lvdlvd/rotanimb01/doc/SETUP-ARDUPLANE.md

# Setup: stock ArduPlane on the bench

End to end, for someone with a NUCLEO-F767ZI, an STM32G474 board and the
parts in [README.md](../README.md). Every step names what "done" looks like. The traps
you will hit along the way are catalogued in [BENCH-OPERATIONS.md](BENCH-OPERATIONS.md) — read
its first section before powering anything.

## 1. Wire it

Common ground FIRST. The harness is a slave on the DUT's SPI3; four
chip selects demux the four emulated devices.

| signal | DUT NUCLEO-F767ZI | harness G474 |
| --- | --- | --- |
| SPI3 SCK | PB3 | PC10 |
| SPI3 MISO | PB4 | PC11 |
| SPI3 MOSI | PB5 | PC12 |
| CS accel | PD3 | PC3 |
| CS gyro | PD4 | PC2 |
| CS baro | PD5 | PC0 |
| CS mag | PD6 | PC1 |
| PWM 1-4 (TIM3) | PC6 / PC7 / PC8 / PC9 | PA0 / PA1 / PB10 / PB11 |
| PWM 5-8 (TIM4) | PD12 / PD13 / PD14 / PD15 | PC6 / PC7 / PC8 / PC9 |
| CAN | PD0 RX / PD1 TX | PB3 RX / PB4 TX — via two 5 V transceivers, STBY to GND |
| GND | common ground | |

DRDY outputs (harness PC4/PC5/PB6/PB7) stay unconnected: this
configuration polls. Only PWM 1-4 (aileron, elevator, throttle, rudder)
matter for flight; 5-8 are captured and reported. The CAN transceivers
need 5 V: at 3.3 V the bus never goes dominant and the DUT's CAN error
counter climbs forever (LEC = bit 0).

USB and consoles: the DUT's user USB (CN13) is SERIAL0/MAVLink; its
ST-Link VCP (USART3) is a debug console. The harness has two links and
you need both:

- its USB (PA11/PA12) is the **pseudocan** command/telemetry link
  (STATUS, DIAG, PARAM_VAL, TRUTH_*, and every command in);
- its **console** is USART1 PA9/PA10 at 115200. The once-a-second
  heartbeat (`fdm 1g`, altitude, psi, the post-lag surfaces, the PWM
  cal echo, the SPI counters) exists ONLY there, and `bench drive`
  reads it back after every command. On the breakout board, PA9/PA10
  go to the ST-Link's VCP pins and the console appears as the
  ST-Link's second CDC interface.

Untested alternative: a NUCLEO-G474RE has the same MCU and pinout, but
its on-board ST-Link VCP is on PA2/PA3 (USART2), PC13 is the user
button, and PA11/PA12 have no USB connector — so it would need a
USB-serial adapter on PA9/PA10 (`ROTANIMB01_CONSOLE`), a hand-made USB
cable, and the selftest's PA2/PA3 jumpers collide with that VCP. Nobody
has run it; the breakout is the known-good board.

## 2. Build and flash the harness

Toolchain: arm-none-eabi-gcc 15.2 (what this is built and tested with; the
sources are `-std=gnu23`, older compilers are untested),
GNU make, openocd. The harness build needs nothing outside this repository.

```
make -C src            # builds, runs the host-side gates (fdmgate, dccheck)
make -C src flash      # openocd over the ST-Link
```

`make flash` mass-erases the G474 and programs `rotanimb01.elf`. With
more than one ST-Link on the host:

```
make -C src flash OPENOCD_ADAPTER="-c 'adapter serial <serial>'"
```

To find which serial is which, read them off the USB descriptors — both
ST-Links enumerate under the same `/dev/serial/by-id/usb-STMicroelectronics_
STM32_STLink_<serial>-if02` pattern, so record the two serials once and label
them. **Do NOT use `st-info --probe` to tell them apart on a running bench:
it connects over SWD and RESETS THE HARNESS, losing every RAM-only setting
(FDM mode, PWM cal, engine model, noise scales) in one command.** If you have
probed, assume the RAM state is gone and redo section 6 before trusting any
reading.

Done looks like: the breakout LED (PC13, active low) blinks, and the
harness enumerates as a USB CDC device named `rotanimb01 hitl-harness`.
On Linux it appears as
`/dev/serial/by-id/usb-rotanimb01_hitl-harness_<uid>-if00`; on macOS as
a `/dev/cu.usbmodem*`. The console (115200) prints a heartbeat line
once a second: `fdm 0g` means the model is parked and the sensor
emulation serves rest truth. `rb01tool` (section 4) on the pseudocan
port shows STATUS and DIAG arriving at 10 Hz and 1 Hz.

Optional but recommended once: `selftest/` lets the harness master its
own sensor bus with seven jumpers (table at the top of selftest/main.c)
and replays a real driver's init sequences against the four register
models. `make -C selftest flash`, watch the console for PASS per device.

## 3. Build stock ArduPlane for the DUT

The board definition is two commits against upstream ArduPilot master,
shipped as patches in `dut/ardupilot/` (see the README there for what
they contain and why). Applied and built (plane + bootloader) on master as of
2026-07-27 (9bbfed9c91).

```
git clone https://github.com/ArduPilot/ardupilot.git && cd ardupilot
git submodule update --init --recursive
git am /path/to/rotanimb01/dut/ardupilot/*.patch
./waf configure --board NucleoF767ZI
./waf plane
```

Flash over SWD with openocd. The DUT needs connect-under-reset once
ArduPlane is running (a plain `halt` times out); this recipe works from
a cold board too:

```
openocd -f interface/stlink.cfg \
  -c "reset_config srst_only srst_nogate connect_assert_srst" \
  -f target/stm32f7x.cfg -c init -c "reset halt" \
  -c "program Tools/bootloaders/NucleoF767ZI_bl.bin verify 0x08000000" \
  -c "program build/NucleoF767ZI/bin/arduplane.bin verify 0x08018000" \
  -c "reset run" -c shutdown
```

The bootloader owns flash 0..96 K (its code in sector 0, the parameter
storage in sectors 1-2), the application starts at 0x08018000. Do NOT
`stm32f2x mass_erase` on later reflashes — it wipes the parameter
sectors; `program ... verify <addr>` erases only the sectors it writes.
Once the bootloader is on, `./waf plane --upload` over the DUT's USB
also works. The shipped `NucleoF767ZI_bl.bin` is prebuilt; to rebuild it,
`./waf configure --board NucleoF767ZI --bootloader && ./waf bootloader`
from a CLEAN `build/NucleoF767ZI` (the application build leaves
generated DroneCAN sources there that break the bootloader build).

Flash order matters when both boards are up: reset the harness first
(SPI bus quiet), then flash/reset the DUT. Flashing the DUT while the
harness SPI bus is live can wedge ArduPilot's accel driver in a reset
loop that a soft reboot does not clear.

Done looks like: the DUT enumerates as `ArduPilot NucleoF767ZI` on its
user USB and a MAVLink HEARTBEAT arrives (MAVProxy:
`mavproxy.py --master=/dev/serial/by-id/usb-ArduPilot_NucleoF767ZI_*-if00`).
"Config Error: Baro" at this point means an SPI wiring problem or a
harness that is not serving (check its heartbeat).

## 4. Host tools

```
cd rb01tool && go build          # interactive cockpit + PFD
cd tools/bench && go build       # campaign driver; GOOS=linux GOARCH=arm64 for a Pi
```

Go 1.21 or newer, standard library only (bench needs golang.org/x/sys
for termios, fetched by `go build`). `rb01tool -p <port>` names the
harness pseudocan port; without `-p` it looks for exactly one
`/dev/serial/by-id/usb-rotanimb01_hitl-harness_*` (Linux) or
`/dev/cu.usbmodem*` (macOS). tools/px4hil is Go 1.25 and depends on
github.com/lvdlvd/gomavlink (fetched by `go build`).

If the USB devices hang off a separate host (a Pi), run there:

```
bench serbridge -port 5760       # DUT MAVLink <-> TCP
```

and from the workstation add `-c <host-ip>:5760` to every `bench`
command. `bench drive ...` (harness commands) always runs on the host
the harness is plugged into. Device selection: `ROTANIMB01_HARNESS`,
`ROTANIMB01_CONSOLE`, `ROTANIMB01_DUT` name the devices; unset, a
`/dev/serial/by-id/` glob that matches exactly one device is used (two
ST-Links on one host make the console glob ambiguous — set the
variable).

## 5. First boot: parameters

The DUT parameters live in `doc/f5-bench.parm` (annotated — read the
comments, they are the accumulated reasons). Either

```
mavproxy> param load doc/f5-bench.parm
mavproxy> reboot
```

or, with the tool, `bench params -profile bench -reboot`, which stages
the tuning core plus the DroneCAN sensor config (GPS1_TYPE 9, ARSPD_TYPE
8 + SKIP_CAL, ARSPD_RATIO 1.6327), the synthetic INS calibration, and
verifies every write by readback. The tool's list (tools/bench/
missions.go) is the authoritative staged set — it adds NAVL1_DAMPING
0.75 and leaves the parm file's bench-comfort lines (logging off, RTL
autoland) alone; the parm file is the annotated record. Do one of the
two before expecting any fly check to pass.

Then sanity. **Do section 6 (harness init) FIRST if you have not already:**
the IMU, baro and airspeed checks below pass in either FDM mode, but the GPS
and EKF checks REQUIRE `bench drive mode 1` — the DroneCAN GPS feeder produces
no fix until the six-DOF model is running, and the EKF never leaves "waiting
for GPS config data". Measured on the bench: `fdm 0g` gives GPS_RAW_INT
fix=0 sats=0 at lat/lon 0; `fdm 1g` gives fix=3 sats=12 at the origin, with
nothing else changed.

- RAW_IMU: accel ≈ (0, 0, -1000) mg, gyro ≈ 0.
- SCALED_PRESSURE ≈ 1013.25 hPa / 15.0 °C.
- GPS_RAW_INT: fix 3D, 12 sats, position at the feeder origin
  (45.52688 N, 1.667291 E — open farmland in central France). No fix
  with CAN wired = transceiver STBY floating, 3.3 V supply, or swapped
  PD0/PD1.
- AIRSPEED ≈ 0 and healthy (ARSPD_SKIP_CAL 1 — the harness's zero IS
  the truth, and skipping boot cal protects a DUT rebooted mid-flight).
- After ~30 s: "EKF3 IMU0 is using GPS", origin and home set. This is
  the first acceptance gate.

Calibration: the harness is level and still, so use the synthetic INS
values in the parm file (a 6-pose accel cal is impossible — the model
will not hold poses) and a fixed-yaw compass cal (`magcal yaw 0`; the
harness serves the earth field at heading 0 after a reset).

## 6. Harness init — every session, every harness reboot

```
bench drive mode 1          # six-DOF model on, parked on the gear
bench drive setpos 0 0      # at the origin (a bare mode cycle does not reset position)
bench drive cal             # PWM calibration, ArduPilot sign profile — RAM-ONLY
bench drive engine 912      # naturally aspirated 100 hp (default); 915 = turbo, for high altitude
bench drive tail 3          # read the heartbeat back: fdm 1g
```

All of this is RAM state: lost on every harness reboot, reflash or
power cycle. Note what `tail` can and cannot confirm: it shows `fdm 1g`, psi,
altitude and the counters, but **there is no cal readback** — PWM_CAL is
write-only, and the `ctl` line is the post-lag surface deflection computed from
the DUT's live PWM, so at neutral PWM it reads `a 0 e 0 r 0` whether or not the
cal was ever sent. The first real evidence the cal took is the takeoff
rotating; `bench fly` reports "NO ROTATION (overspeed on ground)" if it did not. Without the cal the elevator is inverted for ArduPilot —
the aircraft never rotates, runs off the end of the runway at 50 m/s.
Then `bench reboot` the DUT and wait 45 s (clears a latched
"airspeed unhealthy").

## 7. Fly

The end-to-end check:

```
bench fly -alt 300
```

TAKEOFF-mode departure, climb, 60 s of hands-off FBWA at cruise
throttle, PASS/MARGINAL verdict with roll statistics. PASS = worst |roll| and
|pitch| both under 25° over the hands-off minute. Typical numbers on a healthy
bench land between about 7° and 17°, and which axis is the larger one varies
run to run — **a figure over 12° is NOT by itself evidence of dirty harness
state**, and chasing one with a reset is usually wasted time. A genuine FAIL
(over 25°), or a takeoff that never rotates, does point at harness state: redo
section 6 from a harness reset.

The documented demo flight is the 1 km square at 150 m,
`doc/example-square-1km.waypoints`, laid out from the feeder origin
(south-west corner) north and east. Item 0 of a QGC WPL file is the HOME slot
and ArduPilot overwrites it with the vehicle's own home, so the real mission
starts at item 1 — these files carry a placeholder home row for that reason.
A mission whose NAV_TAKEOFF sits at index 0 loses it silently on upload and
the aircraft then sits at idle throttle in AUTO, looking like a bench fault.
Note also that AUTO alone does not start the ground roll without a throttle
input; depart with `mode takeoff` (what `bench fly` does) and switch to AUTO
once airborne:

```
mavproxy> wp load doc/example-square-1km.waypoints
mavproxy> mode takeoff
mavproxy> arm throttle
        # ... climbing; once through TKOFF_ALT:
mavproxy> mode auto
```

`doc/example-straight-in.waypoints` is the same with a landing at the
origin. `bench loiter -takeoff` flies the two reference loiter legs
(standard 3°/s at 29 m/s, R 553 m; fast 6°/s at 38 m/s, R 363 m) with
demand-vs-achieved statistics and a CSV per leg; `bench probe`
cross-checks yaw vs GPS course vs EKF velocity vs airspeed.

## 8. Truth vs EKF

The harness reports the model's truth at 20 Hz over pseudocan
([TRUTH-TELEMETRY.md](TRUTH-TELEMETRY.md)). `rb01tool` shows it as a PFD next to the model
state; ArduPilot's ATTITUDE / GLOBAL_POSITION_INT from MAVProxy is the
estimate. The two are independent paths through independent hardware:
on a healthy bench they agree to a degree in attitude and metres in
position (the checkride numbers are in [F5-TESTREPORT-2026-07-15.md](F5-TESTREPORT-2026-07-15.md),
night 7). Do not use the DroneCAN GPS feed as truth — it is the
deliberately lagged, quantized feed the DUT consumes.

## 9. SITL first

Everything above also runs with no hardware at all, at 10x real time:

```
cd fdm && make sitljson && ./sitljson &
arduplane --model JSON:127.0.0.1 --speedup 10 --home 52.0,5.1,0,0 -w &
bench params -profile sitl -reboot
bench fly
```

Tune in SITL, then validate through the sensor path on the bench.
[tools/bench/README.md](../tools/bench/README.md) has the campaign tools and the session checklist.
