lvdlvd/rotanimb01/(commit log)

2026-07-08 M0-M3 baseline: skeleton, PWM capture, CAN link, SPI slave engine wired
    The harness app on the n-array platform (../n-array lib/periph/gen):
    - DESIGN.md v2 (hybrid SPI topology), pinout verified against the rebuilt
    AF data (FDCAN1 on PA11/PA12 is AF9), CAN dictionary updated to 29-bit
    bit-field headers + big-endian payloads.
    - src/: board def (narray-pinfmt'd), console + fault machinery, 8-channel
    PWM capture on TIM2+TIM3 (TIM2 doubles as the us clock), FDCAN1 at
    1 Mbit with the shared-dictionary headers (canmsg.h: harness owns the
    0x40 MSGID block), PWM reports 50 Hz + on-change, STATUS 10 Hz with
    stale-command watchdog, DIAG 1 Hz.
    - bmp390inv/: host golden model for the BMP390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
2026-07-08 DESIGN: record the M3-measured SPI slave deadline structure
    Dummy protocols native-speed reactive once the dummy is pre-stuffed at
    select; no-dummy protocols 1.3 MHz clean / 2.6 MHz marginal. Prediction
    reduced to a gyro-only question.
2026-07-08 doc: M4 register maps extracted for verification + DUT-driver findings
2026-07-08 M4a: the four sensor models on the single-SPI v3 topology
    DESIGN v3: all four devices demuxed on one SPI3 slave (M3 measurements
    made v2's hardware-NSS prediction path moot); PA4/PB12 become CS inputs
    on EXTI4/EXTI12, SPI1/SPI2 pins reserved as the hybrid fallback.
    src/sensors.{h,c}: BMI088 gyro+accel, BMP390, RM3100 register files per
    doc/REGMAPS.md — reset values (incl. RM3100 CC defaults, ArduPilot's
    whoami), write masks, deselect frame hooks for clear-on-read + DRDY pin
    release + deferred soft resets, self-test emulation (gyro 0x12 answer,
    accel +-deflection >= 2048 LSB, RM3100 BIST XOK/YOK/ZOK), rates and
    scale factors derived from the live config registers, BMP390 served from
    the tr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
    [board.c, board.h, main.c, sensors.c, sensors.h]
2026-07-08 selftest: M4a probe test; IRQ priorities in preemption levels
    selftest/: the board masters its own sensor bus — v3 freed SPI1, so seven
    jumpers (PA5>PC10 PA7>PC12 PA6>PC11, PB0>PC0 PB1>PC1 PA2>PA4 PA3>PB12) put
    lib/spi.h at 1.3 MHz against the four models and replay the flight-tested
    init sequences: chip ids, self-test dialogues, soft resets, config with
    readback, DRDY pin assertions read back on-chip, and a data check per
    device — the baro raw words are forward-compensated on the master side and
    must reproduce the ISA sea level the slave's trim inversion encoded.
    Shares ../src generated files and sensors/board sources.
    IRQ priorities (harness + selftest), 2:2 grouping in the house styl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
    [main.c, sensors.c, sensors.h]
2026-07-08 M4b: the BMI088 FIFOs as the ArduPilot driver drives them
    sensors.c renders both FIFOs through the engine's streaming register,
    spec extracted from the AP driver (doc/REGMAPS.md addendum): accel
    headered 7-byte 0x84 frames, FIFO_LENGTH le at 0x24, 146-frame capacity,
    silent stop-at-full, cleared by any FIFO config write; gyro headerless
    6-byte frames, FIFO_STATUS count|overrun at 0x0E, 100 frames, overrun
    raised at full and cleared - with the FIFO - by rewriting FIFO_CONFIG1
    (AP's recovery). Wmasks grew the registers AP writes and readback-checks:
    accel 0x45-0x49, gyro RATE_HBW 0x13 + 0x3D/0x3E. Commits append frame +
    length registers in one atomic spidev_apply so a select never observes a
    t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
2026-07-09 M5: physics + 10 kHz table scheduler + CAN command decode
    physics/: commanded NED state (V, hdot, psidot) through 0.4 s first-order
    lags -> coordinated flight (gamma = asin(hdot/V), tan phi =
    psidot*V*cos(gamma)/g, theta = gamma + 2 deg trim AoA) -> strapdown body
    rates, specific force by differentiating the NED velocity vector, tilted
    earth field, ISA baro from QNH + integrated h. All truth in body FRD
    (level = -1 g on z; DUT mounts ROTATION_NONE). Trig is libm, not CORDIC
    (user-approved): the step is small enough, and the model stays dependency-
    free and host-compilable — golden.c asserts the DESIGN maneuver scripts
    and passes (level |f| = g with trim-AoA x; standard turn phi 15.9 deg,
    l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
2026-07-09 v3 CS demux on PC0-PC3; report crashes before bus bring-up. M4 gate PASSED
    The v3 first draft scattered the four CS inputs over three ports (PC0,
    PC1, PA4, PB12) — but spislave's CS handler arbitrates from ONE IDR read
    and spislave_init asserts one port. The assert fired inside sensors_init
    on every boot, BEFORE fault_report ran: a silent reset loop (bench:
    no output at all). Three fixes:
    - CS gyro -> PC2, CS accel -> PC3: all four CS on port C, each on its own
    dedicated single-line EXTI vector (0-3); the shared EXTI15_10 handler is
    gone. board.c completes the v2->v3 migration (SPI1/SPI2 slave pin blocks
    removed to the analog blanket, reserved as the hybrid fallback).
    - fault_report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
    [board.c, board.h, main.c]
2026-07-09 regenerate device.h/devs.ld (USB + CRS); enable tprintf %f
    The generated headers now carry the USB_FS device (EPR[8] form + USB_RAM
    PMA symbol) and CRS, for the upcoming pseudocan-over-USB console (note:
    USB shares PA11/PA12 with FDCAN1 — the two transports are mutually
    exclusive at runtime). Makefiles opt into tprintf float formatting
    (-DPRINTF_ENABLE_FLOAT); libm doubles are already on board.
2026-07-09 host link transport: pseudocan over USB (default) or FDCAN1 (lab)
    TRANSPORT=usb (default): the canmsg dictionary tunnels as pseudocan
    lines (lib/fmtcan, no per-line crc — USB bulk has link-level integrity)
    over the CDC-ACM VCP; the board enumerates as /dev/cu.usbmodem<die-id>.
    Same mailboxes, STATUS/PWM/DIAG streams (port field 1), host lines
    parse straight from the usb fifo into host_msg(), output is DTR-gated
    so nothing accumulates against a closed port. TRANSPORT=can keeps the
    FDCAN1 build for the lab bench. The two share PA11/PA12 — a wiring-
    level either/or, hence a build-time choice (an #ifdef pair to clean
    out once the transport question settles, per the todo).
    board.c: USB kerne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
2026-07-11 F0: fdm host-first — Kitfox V 6-DOF core + golden validation ladder
    fdm/fdm.{h,c} per fdm-DESIGN.md mode 1: 13-state rigid body (body vel,
    rates, quaternion, int32-cm NED position), component-buildup aero with
    C1 smoothstep stall blend to flat plate + pitch-down bias, Beard-McLain
    prop (anchors: 1600 N static, 890 N at 46 m/s 75%) with torque reaction,
    steady wind + Gauss-Markov gusts (off by default), semi-implicit Euler.
    Freestanding float32: cordic float API only, no libm, no doubles; ISA as
    a 16-knot cubic Hermite table built once with cordic exp/log (hydrostatic
    derivatives at the knots); -Wdouble-promotion -Werror. Sequential level
    trim (CL->alpha->de, drag->throttle) with IAS in, TA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
    [fdm.c, fdm.h, golden.c]
2026-07-11 harness baro: emulate the bench BMP388 — real NVM trim + CHIP_ID 0x50
    The BCLBR dump from the real part (via srcg4 on the bench) replaces the
    synthetic trim, so the emulated register file serves the actual part's
    NVM byte-for-byte; CHIP_ID goes 0x60 -> 0x50 (BMP388, as on the bench;
    both ids accepted by every driver in play). Verified: trim_regs
    reproduces the dump exactly, and the inversion round-trips < 3 Pa /
    0.02 C over -20..50 C x 540..1060 hPa with the real coefficients.
    Selftest expectation updated.
    [main.c, sensors.c]
2026-07-12 sensors: DRDY pins pulse per sample; mag rate from cycle counts; frame trace
    DRDY semantics: only the gyro auto-released its DRDY (300 us); accel,
    baro and mag held a level until a data read cleared it. The DUT arms
    its EXTIs after probing, so a level asserted during the probe never
    yields an edge and never gets read — deadlock. Real parts re-pulse
    per sample (non-latched interrupts): all four DRDYs now assert at
    commit and auto-release 300 us later in sensors_poll (commits take
    now_us).
    Mag rate: TMRC is only the ceiling — the cycle counts set the
    measurement duration, ~30000/CC Hz over three axes (CC=150 -> 200 Hz,
    matching the bench part).
    Bring-up tooling: every frame hook pushes {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
2026-07-12 heartbeat: scrubfail + qcmd engine probes (chained-frame displacement hunt)
2026-07-13 heartbeat: drop the scrubfail/qcmd probes — the select race is gone
    Bench state with n-array's permanently-selected spislave: all four
    sensor pipelines flight-exact through the emulator (gyro quaternion
    integrating, accel autoscale converged to -1 g, mag at earth field,
    baro round-tripping the real trim), tsync at ~1 us DTS, 357k frames
    with zero unexpected/stray at 78% bus utilization.
2026-07-13 rb01tool: console cockpit for the harness over pseudocan/USB
    Connects to the CDC-ACM port, repaints the live state ~10x/s (STATUS
    with psi and the cmd-stale badge, PWM 1-8, DIAG, a rate table of all
    traffic) and steers the physics from single keys: V/v speed, H/h
    climb, R/r turn rate, SPACE level, P/p QNH, T/t temperature, e ISA
    reset. CMD_STATE auto-repeats at ~3 Hz with a rolling seq so the
    harness's 1 s stale timer stays fed; CMD_ENV goes every 2 s.
    Wire codec per lib/fmtcan and src/canmsg.h: lenient parser (crc,
    port, fmi each optional; a present crc must verify), sends carry the
    crc; priority-preserving header representation as in lib/can.h.
    Tests anchor the codec to a line captured of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
2026-07-13 F1: the six-dof flies on the harness at 1 kHz behind the mode switch
    fdm.c joins the target build with its gate: fdm.o must compile
    -Wdouble-promotion -Werror clean and reference no soft-double helpers
    (FPU float32 + CORDIC only; CORDIC clock enabled in board init). The
    cordic frontend now provides sinf & co for the whole image — they beat
    libm at link time; only mode-0's asinf still comes from newlib.
    The 10 kHz scheduler gains a 1 kHz six-dof slot behind fdm_mode; all
    six truth consumers (samplers, baro, STATUS psi, heartbeat) route
    through one truth() switch, mode 0 untouched and default. FDM_MODE
    (TMC 0x43) selects, FDM_INIT (TMC 0x44) air-starts via the trim solver
    at thread level. C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
2026-07-13 rb01tool: FDM mode toggle and air-start keys; full-frame command payloads
    'i' air-starts (FDM_INIT then FDM_MODE 1), 'm' toggles the truth
    source; all command payloads padded to the 8-byte frames the harness's
    truncation guard requires.
2026-07-13 F2: the PWM path — the DUT's servos fly the six-dof
    controls.{h,c}: per-channel AETR calibration (min/trim/max us, signed
    full deflection; defaults 1000/1500/2000, ±20° aileron, ±25°
    elevator/rudder, throttle 0..1), piecewise-linear around trim so the
    DUT's servo trims need not sit at 1500; zero-order hold on the 50 Hz
    captures; first-order servo lag (60 ms surfaces, 0.3 s throttle) with
    a 300 deg/s rate limit, stepped at the FDM's 1 kHz; PWM_CAL (TMC 0x45)
    sets the table live. Failsafe ageing per the design — 100 ms to hold,
    600 ms to calibration trim with throttle to idle, STATUS bit 4 — with
    one refinement: a channel never captured since boot keeps flying the
    FDM_INIT trim solut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
    [canmsg.h, controls.c, controls.h, main.c]
2026-07-13 TRUTH telemetry: the six-dof narrates itself at 20 Hz (F3 first half)
    MEAS 0x44-0x47 in fdm mode: TRUTH_POSVEL (altitude, climb,
    groundspeed), TRUTH_ATT (the quaternion, i16 x 2^15), TRUTH_AIR
    (IAS at sea-level density from qbar, TAS, alpha, beta), TRUTH_CTRL
    (the post-lag deflections and throttle). F3's remaining half — WIND,
    PARAM_SET and its readback — stays open.
2026-07-13 rb01tool: an ascii-art PFD on 'f', fed by the TRUTH telemetry
    Airspeed tape left, altitude tape right, current values boxed and
    bold; compass tape with the boxed heading below; the horizon line
    through the center pitched and rolled per the quaternion (right roll
    renders the horizon rotated counter-clockwise, as a PFD should), a
    fixed __ W __ aircraft symbol, and a data strip with IAS/TAS/ALT/VSI/
    GS plus the live control deflections. Render covered by tests that
    print the art at known attitudes — bench-verified delightful.
2026-07-13 fdm: turncheck — the direction audit the eigenvalue golden can't do
    Right aileron must roll right; a sustained right bank must yaw right
    and turn the velocity vector right — pulsed and held, checked on the
    host with the same cordic math as the target. Result: the model is
    correctly signed and fully coordinated in sustained turns (held +2 deg
    aileron: bank 12->59 deg right, psi through a full right circle,
    course tracking, beta ~+2.5 deg). The pulse case documents the honest
    surprise: the spiral mode is strongly convergent with dutch-roll
    overshoot (a 6.5 deg bank self-levels in ~15 s, briefly carrying a
    LEFT roll rate while still banked right) — moments that read as
    'turning left while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
    [turncheck.c]
2026-07-13 F3b: WIND and PARAM_SET — the tuning surface, plus feeder truth
    WIND (TMC 0x46): steady NED cm/s + Gauss-Markov gust sigma/tau.
    PARAM_SET (TMC 0x47): any fdm table entry by float index, with the ISA
    rebuild side effect handled in fdm_param_set; index|0x8000 reads back
    as PARAM_VAL (MEAS 0x48). TRUTH_POS (0x49) and TRUTH_VEL (0x4A) join
    the 20 Hz truth set — the GPS feeder needs N/E position and the NED
    velocity vector, not just the PFD's altitude and groundspeed.
2026-07-13 rb01tool: F4 — the DroneCAN GPS/airspeed feeder, and wind/gust keys
    -gps <port> republishes the (configurably lagged, default 150 ms)
    flight truth as uavcan.equipment.gnss.Fix2 + air_data.RawAirData at
    5 Hz onto a second pseudocan port — the canusb bridge to the DUT's CAN
    bus. Zero-lag GPS would make HITL kinder than reality, so the lag is a
    first-class flag. The differential pressure comes exactly from IAS
    (the harness defines IAS from qbar, so 0.5*rho0*IAS^2 round-trips).
    dronecan.go is a minimal UAVCAN v0 broadcast encoder: faithful ports
    of libcanard's bit codec, float16 and transfer CRC/framing, message
    layouts per ArduPilot's dsdlc — and every byte pinned by tests against
    refere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
2026-07-13 F4 on board: the harness feeds DroneCAN GPS + airspeed itself
    FDCAN3 on PB3/PB4 straight onto the DUT's CAN bus — no bridge board,
    no second USB hop, and the GPS lag is exact against the harness's own
    microsecond clock. Fix2 + RawAirData at 5 Hz from a lagged ring of fdm
    truth snapshots (default 150 ms, GPS_CFG TMC 0x48 sets enable and lag
    in 10 ms units), NodeStatus at 1 Hz so ArduPilot sees node 42 alive.
    Position in integer 1e-8-degree math from a 52N/5.1E origin — float32
    cannot carry those magnitudes. Differential pressure is exactly
    0.5*rho0*IAS^2, the inverse of how the harness defines IAS.
    dronecan.{h,c}: a freestanding UAVCAN v0 broadcast encoder — faithful
    ports of libcanard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
    [board.c, canmsg.h, dccheck.c, dronecan.c, dronecan.h, main.c]
2026-07-15 F5 checkride: the harness learns to fly ArduPlane for real
    The bench nights' harvest, in one coherent state:
    DroneCAN feeder made transport-independent and honest: FDCAN clock,
    pins, irq handlers and vector slots out of the TRANSPORT_CAN ifdefs
    (three separate latent deaths in USB builds, one per layer); the
    missing IR.RF1N w1c in fdcan3_it1 — first RX frame ever = permanent
    interrupt storm at 100% CPU (console, USB and SWD all dark; masked for
    days by the DUT's dead transceiver); Fix2's 13-frame bursts queued
    through lib/canmsgq and pumped from the tx-complete irq (3 hw buffers
    truncated every transfer); all CAN drains bounded per the aerospace
    rule; gps tx/busoff/LEC counters on the hea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
    [f5-bench.parm]
2026-07-15 doc: F5 flight test report — checkride flown
    Chain proven end to end; takeoff and FBWA pass outright, LOITER-in-wind
    and TECS climb functional pending airframe tuning. Thirteen defects
    found and fixed across two bench nights — the HITL rig doing its job.
2026-07-15 M7'-lite noise layer, toe brakes, and the night-3 verdict: tuning holds
    Datasheet-scale white noise on gyro/accel/mag (physical units, before
    quantization, so it tracks the DUT's configured ranges) joining the
    baro dither. The acceptance mission completes with noise at the same
    envelope as without — the DUT is not living off unnatural cleanliness.
    Ground model: toe brakes below 15% power — the power-based prop pushes
    ~160 N at ArduPilot's disarmed idle and the aircraft taxied itself in
    circles (which also wedged the DUT's estimator into a never-recovering
    inverted attitude; the bench driver now auto-reboots the DUT when the
    parked estimate is stuck, exercised four times unattended).
    f5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
    [f5-bench.parm]
2026-07-15 gyro bias: turn-on offset + 3D random walk — the noise that matters
    A wandering gyro bias is why attitude filters carry bias states and
    lean on accel+mag as the low-bandwidth reference; without it the EKF's
    hardest job was missing from the bench. BMI088-class numbers: per-boot
    turn-on sigma 0.15 deg/s (the DUT's boot cal now removes something
    real), in-run walk 0.002 deg/s per sqrt(s) (the EKF must keep
    tracking). Small fixed accel turn-on bias too. The acceptance mission
    completes with the full model — validated in flight.
    Bench driver: auto-reboot the DUT when its parked attitude estimate is
    stuck (post-crash railed-bias lockup), takeoff retries wired through.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
    [main.c]
2026-07-16 autotune cracked: event-based learning, in-mode readback, learned gains
    AP_AutoTune learns only from events (rate demand over ~30 deg/s with
    attitude error over 12 deg), fits FF per event with a 4-event median,
    then raises D and P to provoked oscillation — and restores everything
    on mode exit unless both limits were found. Stick holds produce no
    events; bank-crossing reversals do. tools/bench/autotune2.py flies the
    correct pattern and reads gains while still in the mode. Learned: this
    airframe wants ~9x default roll FF. Candidates in f5-bench.parm; the
    mission completes with them, and the residual loiter excursions now
    read as demand-side, not tracking.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
    [f5-bench.parm]
2026-07-16 night 4 consolidation: roll tune validated, pitch tune rejected by A/B
    Autotuned roll gains are A/B-proven good; both autotuned pitch ladders
    ended in crashes and their gains destabilize the loiter — pitch stays
    at defaults, documented with the convergent FF for a future completed
    tune. Loiter radius per the owner's airmanship: rate-turn geometry
    (300 m), not tight circles. Demand-vs-achieved instrumentation lands
    in the mission driver and immediately reframes the problem: L1 demands
    37 deg median bank where the orbit needs 19, and roll tracking error
    is ~20 deg median across all gain sets — next session wants dataflash
    logs, not more blind runs. Takeoff: proportional EMA speed-hold clim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
    [f5-bench.parm]
2026-07-16 night 5: instrumented loiter campaign — findings chain
    Standard/fast loiter per the owner (3 and 6 deg/s), flown with 25 Hz
    recording and offline analysis. The chain: the model's true cruise is
    38 m/s (the owner's 90 kt — the prop model is his engine); the first
    legs commanded a speed below the accelerated stall at the demanded
    bank, making rosettes of the orbits; WP_LOITER_RAD latches at mode
    entry and DO_CHANGE_SPEED is inert in LOITER; with all that fixed the
    remaining, precisely-characterized problem is L1 loiter capture
    (saturated bank demand orbiting a displaced center). Bonus fidelity
    milestone: the gyro bias walk drifts DCM into the DCM-vs-EKF arming
    check — the bench now repro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
    [f5-bench.parm]
2026-07-16 night 7: SITL rig cracks the tuning; bench flies identical to the model
    fdm/sitljson.c: ArduPilot SITL JSON-backend wrapper around the same
    fdm.c the harness flies (SIL under the HIL) — lockstep UDP :9002,
    harness actuator model included, --speedup 10 tuning campaigns.
    Tuning results (SITL, validated on the bench):
    - pitch AUTOTUNE completed: FF 1.6387 P 8.3447 I 6.2585 D 0.4981,
    TCONST 0.75 (the bench ladders never got through; FF matches their
    ~1.65 convergence)
    - both loiter legs textbook on BOTH rigs: std 29.0 m/s R568/569,
    fast 38.0 m/s R374 — identical to the meter
    Three latent bench defects closed on the way:
    - harness PWM cal is RAM-only; reboot reverts elevator to the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
    [f5-bench.parm]
2026-07-16 docs into doc/, stack README, tools/bench rewritten in Go
    DESIGN.md and fdm-DESIGN.md move to doc/ (source references updated);
    a top-level README now documents the whole HITL + SITL stack: the
    loop, directory map, both rigs, and the short list of operational
    truths (the long list stays in the test report and parm comments).
    tools/bench: the python campaign scripts are replaced by one Go
    binary (stdlib + x/sys, no cgo) with subcommands params / fly /
    loiter / probe / tune / disarm / reboot / drive / serbridge — the
    python that flew the F5 checkride remains checkpointed at 537e750
    for A/B re-verification. The MAVLink2 codec carries only the
    dictionary this bench speaks and is byte-pinned b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
    [board.c, board.h, fdm.c, main.c]
2026-08-06 bench: ride out wifi outages in the param path
    Two campaigns died on 2026-08-06 with all retries spent inside a single
    multi-second wifi outage (bench RTT swings 6 -> 437 ms, occasional
    outright drops): params staging aborted on AIRSPEED_CRUISE, and a
    loiter campaign died at its first leg's speed change. Get/SetParam now
    try 6 x 3 s (18 s horizon), and cmdParams collects failures for a second
    full pass instead of aborting on the first. leg() stays strict: a leg
    flown at an unverified speed is mislabeled data.
2026-08-06 bench: mode subcommand
    bench mode rtl is the missing "bring it home" — with RTL_AUTOLAND 2
    staged the plane flies home and lands itself, which beats leaving a
    probe-abandoned FBWA plane to wander into the ground.
2026-08-06 harness: GPS feeder origin to the vnav map region
    52.0N/5.1E was a placeholder; the camera's map tiles, model and golden
    frames live at 45.52688N/1.667291E (Limousin, golden frame f15), so the
    bench now flies where the camera can navigate. East cm->deg factor
    recomputed for cos(45.52688) = 0.70057. Origin remains hardcoded — if
    regime moves become routine, promote it to a command like FDM_INIT.
    Bench-verified: DUT GPS_RAW reads 45.52688/1.66729 at the parked
    origin; airstart 4595 m trims and flies (ISA density honest to 5100 m).
2026-08-06 bench: arm subcommand (airstart flights arm on the ground first)
2026-08-07 harness: stale-timer wrap — fdm enabled after ~36 min emitted nothing
    The 20 Hz TRUTH_*, 5 Hz DroneCAN feed and 1 Hz NodeStatus timers
    compared (int32_t)(now - t_x) against their periods with t_x still 0
    from boot. Past 2^31 us (~35.8 min) of uptime that difference wraps
    negative, so a session that enabled fdm_mode late got a harness that
    stepped the FDM and printed "fdm 1" on the console while emitting no
    truth and no GPS — exactly the 2026-08-07 morning bring-up, and
    retroactively yesterday's "gps tx at 1 Hz" puzzle. Unsigned deltas:
    first fire immediate, wrap-safe forever.
2026-08-07 fdm: the engine is a configuration — honest 912iS default, 915iS preset
    The power-based prop used a hardcoded 74600 W with no density
    dependence: a perfect-turbo fantasy at any altitude (and the CpSp
    param the "turbo" tweak scaled was torque-only — a no-op; yesterday's
    altitude rescue was the wider loiter radius all along). Engine is now
    three runtime params: power_w, t_static_n, crit_alt_m. Naturally
    aspirated engines (crit_alt 0) lapse with density from sea level; a
    turbo holds rated power to crit_alt and lapses above. Defaults are the
    owner's actual 912iS (74600 W, 1601 N, NA); `bench drive engine 915`
    presets the turbocharged 915iS (141 hp to FL150) so high-altitude HITL
    flies a lega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
2026-08-07 src: adapt to the n-array family split (dma_g4.h + usart_v3.h)
    n-array 34bfac9 split dma.h/serial.h into family headers (G4 behavior
    unchanged); the app now pulls dma_g4.h and usart_v3.h explicitly.
2026-08-10 sitljson: optional UDP truth tap for the SITL visual-nav driver
    sitljson [truth_port] mirrors the JSON reply (decimated to ~10 Hz) to
    localhost:<port> — the nav driver reads the same truth the autopilot's
    sensors derive from, the software twin of the bench's TRUTH_* stream.
2026-08-15 bench: watch + hdgaltcmd subcommands, alt/aspd error in state; sitljson airstart port; fix harness console default
    - bench watch: passive state stream (mode/alt/climb/ias/thr/pitch/nav/
    roll + NAV_CONTROLLER alt & aspd errors) for diagnosing mode behavior
    without touching the aircraft.
    - bench hdgaltcmd: send HDGALT_COMMAND (dev msg 52100) so recipes can
    set the altitude target explicitly instead of relying on capture-at-
    entry — required after an airstart teleport (stale-target dive).
    - sitljson: UDP :9003 'airstart <alt> <ias> [hdg]' with the harness's
    fdm_trim semantics, so the SITL rig can replicate bench airstarts.
    - drive.go: default harness console ST-Link path was a stale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
    [sitljson.c]
2026-08-15 sitljson: send EAS, not TAS, in the JSON airspeed field
    SIM_JSON feeds the received airspeed straight into its pitot model,
    whose convention is EAS. Sending the fdm's va (TAS) read ~26% high at
    4600 m, tripping ArduPilot's airspeed consistency check (sensor
    disable/re-enable flapping) and HDGALT's airspeed-floor disengage at
    the airstart teleport. Convert via qbar exactly as the harness does
    for TRUTH_AIR ias.
2026-08-28 harness: FDM_POS (0x49) bench rehome; bench drive setpos + airstart heading fix
    drive airstart silently dropped its heading argument (payload bytes
    4-5 were never filled) — now sent, plus optional [north_m east_m]
    rehome-then-trim. New CANMSG_FDM_POS teleports the FDM ground position
    (N/E cm; alt/attitude/energy untouched) so a wandered bench aircraft
    returns to the vnav origin in one command instead of a 90-minute
    transit. Flashed + verified on the bench 2026-08-28.
    [canmsg.h, main.c]
2026-08-28 serbridge: tolerate VMIN=0 empty reads; reopen only on persistent EOF
    openSerial configures the tty VMIN=0/VTIME=0, on which a drained
    cdc-acm buffer read()s 0 bytes — io.EOF to Go — and serbridge treated
    any EOF as a lost device and reopened. A freshly opened fd starts
    empty, so the reopen read EOF again: a self-sustaining EOF/reopen
    storm (the all-day 2026-08-28 '54 s CDC wedge' metronome, 227 kernel
    resets — the device was healthy throughout; pyserial read 37 KB of
    clean truth from the 'wedged' port mid-storm). Now an EOF is treated
    as no-data-right-now and the reopen fires only after 2 s of
    continuous EOF with no bytes, which still recovers real unplugs
    (bench power cycles), the re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
2026-08-28 bench fly: record a roll-vs-demand series during the hands-off leg
    The wobble debug wanted the oscillation period (rate-loop seconds vs
    L1's ~17 s) and whether demand leads or follows; cmdFly now samples
    attitude/nav/servo at 10 Hz into fly-handsoff-<ts>.csv. First use
    resolved the 2026-08-28 blocker: the 39-40 deg readings were dirty rig
    state — a clean ladder flies the leg at |roll| <= 0.3 deg with the
    worst-case being the FBWA-entry transient decaying in ~3 s.
2026-08-29 px4hil: PX4 SITL bridge around the harness fdm, flight-verified v0.2
    Go+cgo wrapper serving HIL_SENSOR (250 Hz, dithered) + HIL_GPS (5 Hz)
    to PX4's simulator-mavlink TCP-client mode on :4560, with the harness
    actuator-lag model and a sitljson-format -truth JSON UDP tap for the
    vnav driver.
    Bring-up fixes over the v0.1 draft: negate elevator/rudder (PX4 outputs
    are +ve-body-torque, the fdm uses classic aero signs, same negation
    sitljson does for ArduPilot), fix the 100x GPS lat/lon scale (PosCm is
    cm), and dither each sensor at its noise floor because PX4's
    DataValidator declares a source STALE after 100 bit-identical samples.
    Verified against px4_sitl_default + the 5100_px4hil_kitfox airfr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
2026-09-01 harness: close four emulator gaps a second SPI consumer exposed
    Flying PX4 against the same harness that flies ArduPilot exercised
    register behavior real silicon has but ArduPilot's drivers never
    touch, so the emulation never modeled it:
    - the BMI088 accel FIFO is entered EARLY: PX4's driver reads
    FIFO_LENGTH_0/1 (0x24/0x25) and the 0x26 burst port in one
    transaction, relying on the part's address increment. Served by
    mirroring the two length bytes into the stream head and entering
    the port two registers early (n-array stream_prefix, 32a90d2).
    - gyro FIFO_WM_ENABLE (0x1E) made writable; PX4 writes it, and a
    refused write fails its probe.
    - baro TRIM_CRC (0x30) now serves the Bosch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
    [sensors.c]
2026-09-01 bench drive cal: per-autopilot profiles (ardupilot|px4)
    The two stacks want different PWM sign conventions from the same
    harness: ArduPilot flips only the elevator; PX4 outputs positive
    body torque in FRD, so elevator AND rudder flip (ail +20, ele -25,
    rud -25). Bare 'drive cal' keeps the ardupilot profile, so existing
    runbooks are unchanged — but always name the profile: the wrong one
    flies with a reversed rudder. The cal remains harness-RAM-only;
    resend after every harness reboot or reflash.
    Verified surface-by-surface disarmed via actuator_test against the
    harness decode, then by the flown missions.
2026-09-01 doc: PX4 bench mission files (1 km square, straight-in landing)
    QGC WPL 110 files as flown on the bench: the 6-item square that
    produced mission-truth-20260831.csv, and the 4-item straight-in
    (NAV_TAKEOFF 150 m, 120/80 m approach, NAV_LAND at the feeder
    origin) that verified the FW_LND_USETER=0 landing fix 2026-09-01.
    PX4 mission-protocol notes (no home item at seq 0, no re-sent
    MISSION_COUNT mid-transfer) live with cmd/px4scaffold in vnavigator.
2026-09-02 vendor the n-array lib into src/nlib: self-contained, missing-only refresh
    This repo now builds with no n-array checkout anywhere on the path. The lib
    sources it actually uses are copied into src/nlib/ and the narray-generated
    files sit in src/, all tracked; selftest/ and fdm/ share that one copy and
    delegate to src/ for it, as they already did for the generated headers.
    The rules that fetch and generate carry NO prerequisite on the checkout, so
    a file already present is never refreshed behind your back: n-array can
    evolve freely without breaking anything here, and these copies are ours to
    edit. The single gesture that reaches upstream is
    make -C src n-array-clean && make -C src
    which ta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
    [binary.h, can.h, canmsgq.h, clock.c, clock.h, console.c, console.h, cordic.h]
2026-09-02 fdm, bmp390inv: vendor the two sibling-repo files, same model as nlib
    The last two things this repo reached outside itself for were host-test
    inputs: fdm's golden linked cordic-math's math_emul.c, the bit-exact host
    emulation of the CORDIC, and bmp390inv's golden compiled bminator10's
    bmp388.c as the integer reference its inverse is checked against. Both are
    now copies here, under the same rule as nlib/ — no prerequisite on the
    sibling checkout, so a present copy is never refreshed, and
    make cordic-math-clean && make (in fdm)
    make bminator10-clean && make test (in bmp390inv)
    is how you deliberately take the current one and see whether we still agree
    with it. The clean targets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
2026-09-08 bench drive gps: enable/disable the harness DroneCAN GPS feeder
    `bench drive gps <0|1> [lag_ms]` sends GPS_CFG (canmsg.h 0x48: u8 enable,
    u8 lag in 10 ms units, zero-padded frame) — the runtime switch the
    harness already honoured but no tool exposed. Needed for the prod-0.1
    acceptance's GPS-denied segment (release-manager prereg 2026-09-08)
    without touching the autopilot's parameter sector. Pinned wire vectors
    in drive_test.go, header derived independently from the id29 layout
    comment.
    User word 2026-09-08 via the leader ("yes to c").
2026-09-08 harness: DroneCAN air data at 20 Hz, unconditional from boot
    The DUT never bound an airspeed sensor. Measured on the bench: valid
    RawAirData on the wire from node 42 (differential 703.9 Pa => 33.9 m/s,
    correct DSDL layout and signature) while ArduPlane kept ARSPD_DEVID at 0
    across clean boots. Cause is on the consumer side and is one-shot:
    AP_Airspeed::init() runs exactly once (AP_Vehicle.cpp:450) and
    AP_Airspeed_DroneCAN::probe() binds only a node whose RawAirData has
    ALREADY been handled, so a feeder that starts talking later never binds
    for that boot. Ours started talking only in fdm mode 1.
    So RawAirData leaves gps_feed() for its own gps_feed_air(), sent from the
    first scheduler tick wi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
    [main.c]
2026-09-11 build: self-contained tree, MIT licence
    Everything the firmware and the host tools compile now lives in this
    repository: the bare-metal support library in src/nlib, the generated
    device files beside src/Makefile, the CORDIC host emulation in fdm/ and
    the BMP388 compensation reference in bmp390inv/ are plain tracked
    sources, and the Makefiles no longer carry refresh rules for them.
    tools/px4hil builds against the published gomavlink module and includes
    the fdm and lib sources from this tree. Section and startup helpers get
    descriptive names (FASTCODE, DMABUF, startup_init_memory,
    startup_remap0); the crash dump's backtrace marker is CRASH-BT. Firmware
    images are byte-identical before and afte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
    [clock.h, cordic_stm32.c, dma.h, exti.h, fault.c, fault.h, fdcan.h]
2026-09-11 tools: device selection by environment or by-id glob
    bench drive/serbridge no longer carry one bench's USB serial numbers:
    ROTANIMB01_HARNESS, ROTANIMB01_CONSOLE and ROTANIMB01_DUT name the
    devices, and without them a /dev/serial/by-id glob that matches exactly
    one device is used. The drive usage strings list setpos, gps and engine.
    Comments on the feeder origin, the engine defaults and the px4hil truth
    tap describe the tool rather than one installation.
    [fdm.c, main.c]
2026-09-12 doc: setup guides for stock ArduPlane and PX4, bench operations, FDM tuning
    New user documentation: doc/SETUP-ARDUPLANE.md and doc/SETUP-PX4.md
    take a stranger from wiring to the 1 km square mission; doc/BENCH-
    OPERATIONS.md is the bring-up ladder plus every trap the bench has
    taught (RAM-only state, power-cycle discipline, engine model ceiling,
    what a reset actually resets); doc/FDM-TUNING.md is the parameter
    table, the golden-check workflow and the observable-to-coefficient
    map; doc/TRUTH-TELEMETRY.md documents the 20 Hz truth feed for
    external consumers. The DUT board definitions ship as patch series
    in dut/ardupilot (2, apply on master 9bbfed9c91) and dut/px4 (5,
    apply on main 7c4bf078f4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
    [f5-bench.parm]
2026-09-12 doc: the DUT boot loop from a desynchronised SPI slave, and known issues
    BENCH-OPERATIONS gains the symptom, the harness-side signature (the
    unexpected-write counter climbing; healthy is 0), the recovery with its
    verification (harness reset, counters back to zero and counting, not
    merely a re-enumeration; a DUT power cycle cannot clear it), and two
    facts that mislead: mode 0 is a flight model, not a quiet bus, and
    bench probe/fly/loiter/tune send mode commands. README gets a known
    issues section, including that ArduPilot's bootloader must be built
    from a clean board build directory.
2026-09-12 doc, tools: fixes from a fresh-eyes walk of the guides
    Toolchain floor is gcc 14 (-std=gnu23). The harness console is the only
    place the heartbeat and command readbacks appear, so the guide says how
    to reach it on a breakout and on a NUCLEO-G474RE (USB-serial on
    PA9/PA10, ROTANIMB01_CONSOLE) and names the Nucleo's other three
    differences. Fly-check verdict stated as the tool computes it (25°).
    Sensor noise is compiled in; CMD_NOISE is documented as reserved. The
    short-period gate's overdamped case is described as the golden treats
    it. bench: usbreset (Linux USBDEVFS_RESET), tools README rewritten to
    the actual subcommand set and bench-host wording, stale error string.
    rb01tool: Linux by-id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
    [f5-bench.parm]
2026-09-12 doc: toolchain as built and tested (gcc 15.2), gomavlink as a dependency, the breakout is the board
    The harness guides name the compiler the tree was actually built and
    tested with; older ones are untested rather than claimed. tools/px4hil
    depends on github.com/lvdlvd/gomavlink, stated plainly. The cheap
    64-pin STM32G474RET6 breakout is the board the guides assume; the
    NUCLEO-G474RE is listed once as an untested alternative with what
    would differ.
2026-09-12 README: photo of the bench in "What you need"
    A picture of the wired-up bench — Pi host, NUCLEO-F767ZI DUT, harness
    breakout on breadboards, CAN transceivers — ahead of the bill of
    materials it illustrates. doc/hitl.png is the full-resolution original;
    the README embeds doc/hitl-small.jpg (574x900, 190 kB) and links
    through to it.
2026-09-12 README: note that a multirotor port is more than a new FDM
    The bus side is airframe-blind, but the FDM/harness contract is not:
    FdmControls is surface-shaped, controls.c hard-codes AETR order and
    surface-deflection calibration, fdm_trim solves level flight rather than
    hover, and the ground model is tricycle gear. Records that, and the
    latency question a port would have to answer.
2026-09-12 doc: include the three sensor datasheets and link the parts to them
    The register models in src/sensors.c are only checkable against the
    documents they were extracted from, and REGMAPS.md cites those by
    revision without being able to hand them to you. Put the three in doc/
    and link them: BMI088 rev 1.3, BMP390 rev 1.7 (BST-BMP390-DS002-07), and
    the RM3100/RM2100 Sensor Suite User Manual V9.0 -- the exact documents
    REGMAPS names as its sources, revisions verified against the files.
    Linked from the three places a reader actually starts: the README's
    opening sentence naming the parts, the device list in DESIGN.md, and the
    "Sources:" line in REGMAPS.md. Not from every one of the ~70 other
    mentio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
2026-09-12 harness: implement CMD_NOISE (0x42), runtime sensor noise scaling
    The 0x42 mailbox has been latching frames since the command was defined
    and nothing ever read it: the noise levels and the gyro bias walk were
    compiled-in constants with no runtime control. README carried it as a
    known issue. Consume the frame.
    Payload is full-state, like WIND: u8 gyro/accel/mag/baro white-noise
    scale, u8 bias scale (the turn-on bias draw and the in-run walk), u8
    flags (bit0 re-draw the turn-on biases, bit1 zero them), in 1/16 of the
    datasheet default, so 16 = 1.0x = what the harness boots with and 0 =
    off. RAM only, like the cal and the engine preset. The defaults are
    unchanged, so a bench that never sends 0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
    [canmsg.h, main.c, sensors.c]
2026-09-12 harness: GPS and pitot noise, scaled by CMD_NOISE bytes 6-7
    The DroneCAN feeder carried no error at all. Fix2 reported truth
    position with a fixed advertised covariance, and the pitot reported
    0.5*rho*ias^2 exactly -- so a parked aircraft sent a bit-identical 0.0 Pa
    forever, the stuck-source pattern PX4's DataValidator rejects after 100
    samples and which leaves ArduPilot's airspeed offset calibration nothing
    to work with. Transport lag was the only degradation modelled.
    The two free pad bytes of the CMD_NOISE frame become the pitot and GPS
    scales, same 1/16-of-nominal encoding as the other five, so this needs no
    new message and no dictionary change beyond naming bytes 6 and 7. The
    levels st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
    [canmsg.h, main.c]
2026-09-12 README: the airspeed quantisation behind the stuck-pitot symptom
    Bench measurement while accepting the noise work: the lag ring stores IAS
    as a u16 in 0.1 m/s units and the differential pressure is computed from
    that, so the transmitted pressure steps ~6 Pa at cruise. At ~45 m/s over
    a 120 s climb that is 20 distinct values spanning 113 Pa -- 5.97 Pa per
    step against 5.5 Pa predicted from 1.225*45*0.1, so the quantiser is
    visible in the data rather than inferred.
    Before the pitot noise existed this emitted a bit-identical value for up
    to 24 consecutive samples, 1.2 s at 20 Hz. PX4's DataValidator
    invalidates a source after 100 identical samples, so the margin was 4x --
    and a climb is the le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
2026-09-12 README: name the consumer at risk in the quantisation known issue
    The entry described the mechanism but left the reader to work out who it
    hurts. PX4's airspeed_selector data-stuck check trips on ~3 s of exactly
    constant IAS in fixed-wing flight (2 s DATA_STUCK_TIMEOUT + the 1 s
    ASPD_FS_T_STOP delay), is enabled by default, and ASPD_FS_T_START = -1
    disables re-enabling in flight -- so on a pre-1.1 image one qualifying
    interval invalidates airspeed for the remainder of the flight, with no
    fallback configured by default.
    Stated with what we actually saw: bin residencies up to 2.9 s measured in
    a climb, no observed trip, a 3% margin and no way to rule it out from the
    surviving logs. Somebody f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
2026-09-12 harness: detect SPI-slave desync and re-arm the engine in place
    Today's acceptance slot established that a DUT reset desynchronises the
    slave FSM -- reproduced three ways, including a plain MAVLink software
    reboot with no debugger attached, so it is not an srst artefact. The
    origin of the rarer unexplained cases is still unlocated, and THIS DOES
    NOT FIX EITHER. It shortens the recovery.
    Detection is not a heuristic. `unexpected` counts write bytes refused by
    the write mask, which is precisely what a shifted command byte produces:
    a read becomes a write and the mask rejects it. A healthy bus sits at a
    hard zero indefinitely -- measured zero across an entire session -- and a
    desynchronised on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
    [main.c, sensors.c, sensors.h]
2026-09-12 harness: the in-place resync does not work — detection only
    Bench-tested today and it failed, so the claim comes out rather than
    shipping unverified. Sequence: DUT polling and counters at zero verified
    as a precondition, then an SWD reset with connect_assert_srst. The
    desync appeared as expected and THE DETECTOR WORKED — it fired within a
    second and kept firing, resync 0 -> 5 -> 13 -> 21 -> 29 over 40 s. But
    unexp climbed 250k -> 710k -> 1.17M -> 1.63M straight through it. The
    counters climb smoothly rather than in bursts, so the bus is
    continuously mis-decoded rather than being re-broken by a looping DUT.
    Whatever the desynchronised state is, an RCC pulse plus spislave_init
    does not cle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
    [main.c, sensors.c, sensors.h]
2026-09-12 harness: the desync resync works when it also resets the register files
    Second attempt, and this one is verified on hardware. The first re-armed
    only the slave engine and had no effect at all; the reason was
    by-construction and is now understood. The desync's known trigger is a
    DUT reset, after which the DUT re-runs its sensor init from scratch and
    expects POWER-ON DEFAULTS, while the harness still held the pre-reset
    emulated register configuration. That is a protocol-state mismatch in
    devs[], not an FSM or phase mismatch in the engine, so spislave_init
    could never have fixed it -- and the harness-reboot cure works precisely
    because sensors_init() resets the register files before re-initiali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
    [main.c, sensors.c, sensors.h]
2026-09-12 doc: fix what a walk-through of the guides on real hardware found
    Someone followed SETUP-ARDUPLANE and BENCH-OPERATIONS end to end on the
    bench, doing only what they say, and recorded where that stops working.
    Nothing was wrong with the hardware; these are the places the documents
    told them something untrue. The three that stop you dead all fail
    silently -- the aircraft simply sits there, which reads as a broken bench.
    Both example missions could not take off. Item 0 of a QGC WPL file is the
    HOME slot and ArduPilot overwrites it with the vehicle's own home, so a
    NAV_TAKEOFF parked at index 0 is discarded on upload with no error. Read
    back out of the vehicle, index 0 had become a plain waypo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
